pav2000/Dehumidifier-2.0/Podval20/DHT.h

/*
 The MIT License (MIT)

 Copyright (c) 2016-2017 winlin

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
 THE SOFTWARE IS PROVIDED "AS IS", WITHOUT WARRANTY OF ANY KIND, EXPRESS OR
 IMPLIED, INCLUDING BUT NOT LIMITED TO THE WARRANTIES OF MERCHANTABILITY,
 FITNESS FOR A PARTICULAR PURPOSE AND NONINFRINGEMENT. IN NO EVENT SHALL THE
 AUTHORS OR COPYRIGHT HOLDERS BE LIABLE FOR ANY CLAIM, DAMAGES OR OTHER
 LIABILITY, WHETHER IN AN ACTION OF CONTRACT, TORT OR OTHERWISE, ARISING FROM,
 OUT OF OR IN CONNECTION WITH THE SOFTWARE OR THE USE OR OTHER DEALINGS IN THE
 SOFTWARE.
 */
// pav2000 переделано под stm32+freeRTOS

#ifndef _DHT_H
#define _DHT_H
#include <Arduino.h>

// High 8bits are time duration.
// Low 8bits are error code.
// For example, 0x0310 means t=0x03 and code=0x10,
// which is start low signal(0x10) error.
// @see https://github.com/winlinvip/SimpleDHT/issues/25
#define simpleDHTCombileError(t, err) ((t << 8) & 0xff00) | (err & 0x00ff)
#define SimpleDHTErrSuccess      0    // Success.
#define SimpleDHTErrStartLow     0x10 // Error to wait for start low signal.
#define SimpleDHTErrStartHigh    0x11 // Error to wait for start high signal.
#define SimpleDHTErrDataLow      0x12 // Error to wait for data start low signal.
#define SimpleDHTErrDataRead     0x13 // Error to wait for data read signal.
#define SimpleDHTErrDataEOF      0x14 // Error to wait for data EOF signal.
#define SimpleDHTErrDataChecksum 0x15 // Error to validate the checksum.
#define SimpleDHTErrZeroSamples  0x16 // Error when temperature and humidity are zero, it shouldn't happen.
#define SimpleDHTErrNoPin        0x17 // Error when pin is not initialized.

class SimpleDHT {
protected:
    long levelTimeout = 5000000; // 500ms
    int pin = -1;
public:
    SimpleDHT();
    SimpleDHT(int pin);
public:
    // to read from dht11 or dht22.
    // @param pin the DHT11 pin.
    // @param ptemperature output, NULL to igore. In Celsius.
    // @param phumidity output, NULL to ignore.
    //      For DHT11, in H, such as 35H.
    //      For DHT22, in RH%, such as 53%RH.
    // @param pdata output 40bits sample, NULL to ignore.
    // @remark the min delay for this method is 1s(DHT11) or 2s(DHT22).
    // @return SimpleDHTErrSuccess is success; otherwise, failed.
    virtual int read(byte* ptemperature, byte* phumidity, byte pdata[40]);
    virtual int read(int pin, byte* ptemperature, byte* phumidity, byte pdata[40]);
    // to get a more accurate data.
    // @remark it's available for dht22. for dht11, it's the same of read().
    virtual int read2(float* ptemperature, float* phumidity, byte pdata[40]) = 0;
    virtual int read2(int pin, float* ptemperature, float* phumidity, byte pdata[40]) = 0;
protected:
    // (eventually) change the pin configuration for existing instance
    // @param pin the DHT11 pin.
    void setPin( int pin );
protected:
    // measure and return time (in microseconds)
    // with precision defined by interval between checking the state
    // while pin is in specified state (HIGH or LOW)
    // @param level    state which time is measured.
    // @param interval time interval between consecutive state checks.
    // @return measured time (microseconds). -1 if timeout.
    virtual long levelTime(byte level, int firstWait = 10, int interval = 6);
    // @data the bits of a byte.
    // @remark please use simple_dht11_read().
    virtual byte bits2byte(byte data[8]);
    // read temperature and humidity from dht11.
    // @param data a byte[40] to read bits to 5bytes.
    // @return 0 success; otherwise, error.
    // @remark please use simple_dht11_read().
    virtual int sample(byte data[40]) = 0;
    // parse the 40bits data to temperature and humidity.
    // @remark please use simple_dht11_read().
    virtual int parse(byte data[40], short* ptemperature, short* phumidity);
};

/*
    Simple DHT11
    Simple, Stable and Fast DHT11 library.
    The circuit:
    * VCC: 5V or 3V
    * GND: GND
    * DATA: Digital ping, for instance 2.
    23 Jan 2016 By winlin <winlin@vip.126.com>
    https://github.com/winlinvip/SimpleDHT#usage
    https://akizukidenshi.com/download/ds/aosong/DHT11.pdf
    https://cdn-shop.adafruit.com/datasheets/DHT11-chinese.pdf
*/
class SimpleDHT11 : public SimpleDHT {
public:
    SimpleDHT11();
    SimpleDHT11(int pin);
public:
    virtual int read2(float* ptemperature, float* phumidity, byte pdata[40]);
    virtual int read2(int pin, float* ptemperature, float* phumidity, byte pdata[40]);
protected:
    virtual int sample(byte data[40]);
};

/*
    Simple DHT22
    Simple, Stable and Fast DHT22 library.
    The circuit:
    * VCC: 5V or 3V
    * GND: GND
    * DATA: Digital ping, for instance 2.
    3 Jun 2017 By winlin <winlin@vip.126.com>
    https://github.com/winlinvip/SimpleDHT#usage
    http://akizukidenshi.com/download/ds/aosong/AM2302.pdf
    https://cdn-shop.adafruit.com/datasheets/DHT22.pdf
*/
class SimpleDHT22 : public SimpleDHT {
public:
    SimpleDHT22();
    SimpleDHT22(int pin);
public:
    virtual int read2(float* ptemperature, float* phumidity, byte pdata[40]);
    virtual int read2(int pin, float* ptemperature, float* phumidity, byte pdata[40]);
protected:
    virtual int sample(byte data[40]);
};

#endif 
