pav2000/Dehumidifier-2.0/(commit log)

2020-11-16 Первоначальная заливка
2020-11-16 Схема
2020-11-16 Замена картинок
2020-11-16 Добавлена картинка вебморды
2020-12-24 Добавлен сброс контроллера из веб морды, и инициализация дисплея раз в сутки
